bryanherdianto/HOLO/(list of files, drawings)

Other design files:
circuit.pdsprj
