bryanherdianto/HOLO/(commit log)

2025-05-13 added code and initial structure
    [circuit.pdsprj]
2025-05-17 updated readme and fixed code
    [circuit.pdsprj]
2025-05-18 fixed code again to accomodate for physical circuit
    [circuit.pdsprj]
